BTTLab/simple_and_affordable_lps/Ultimate_LPS.pdf

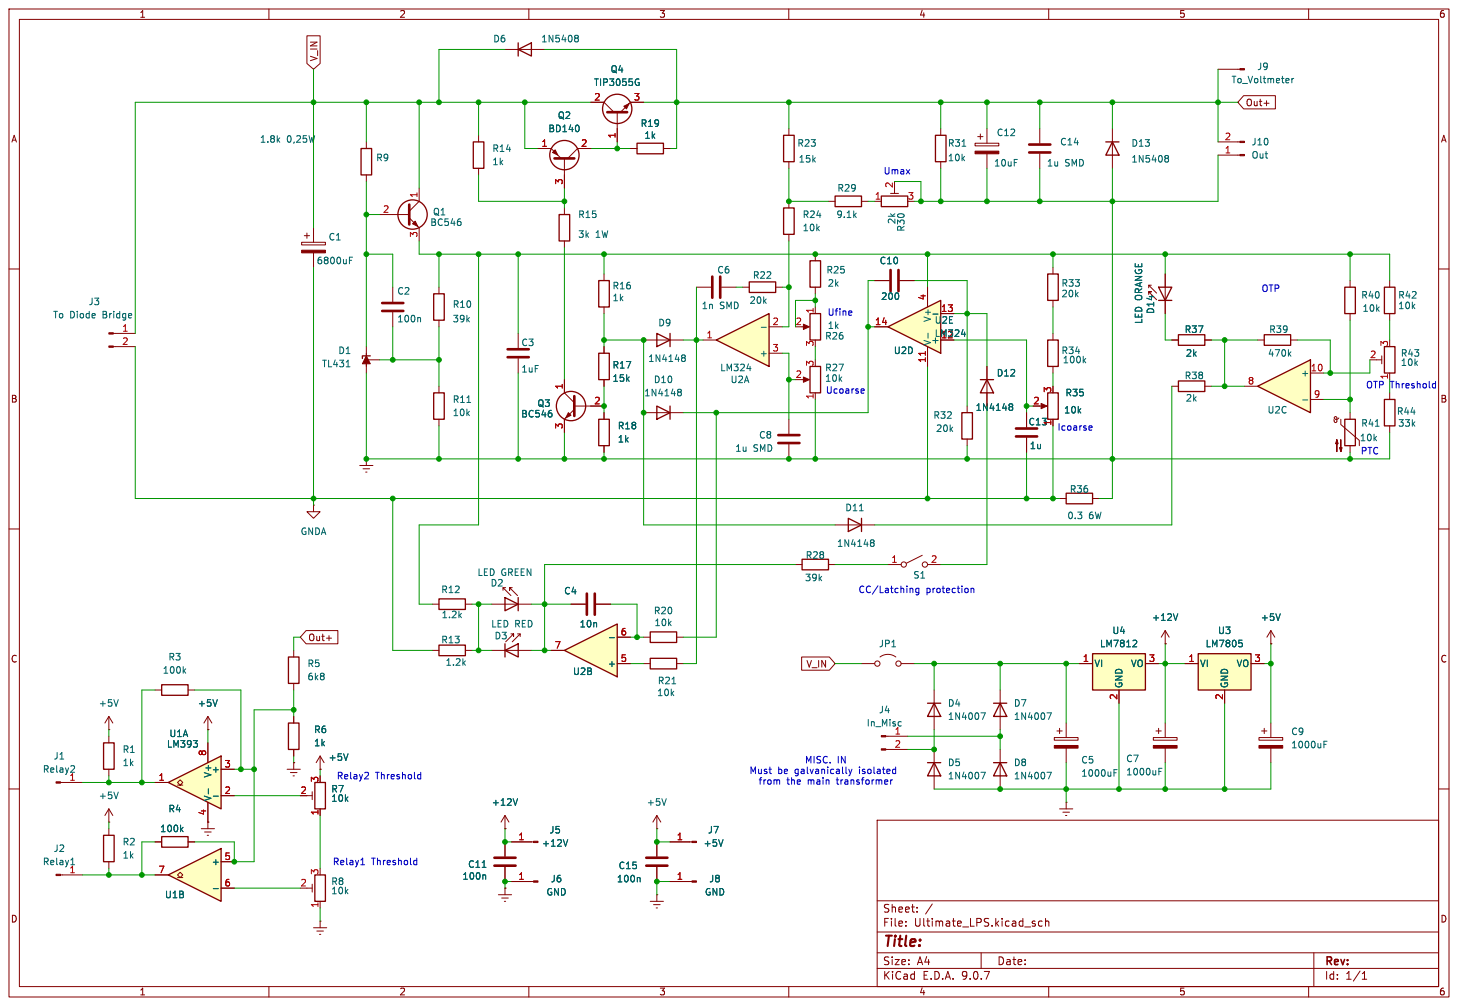
[picture p1: page 1]

Id: 1/1 Title: File: Ultimate_LPS.kicad_sch Sheet: /
