BTTLab/simple_and_affordable_lps/Ultimate_LPS/Ultimate_LPS.kicad_pcb

## KiCad design Ultimate_LPS/Ultimate_LPS.kicad_pcb (2026-10-14)

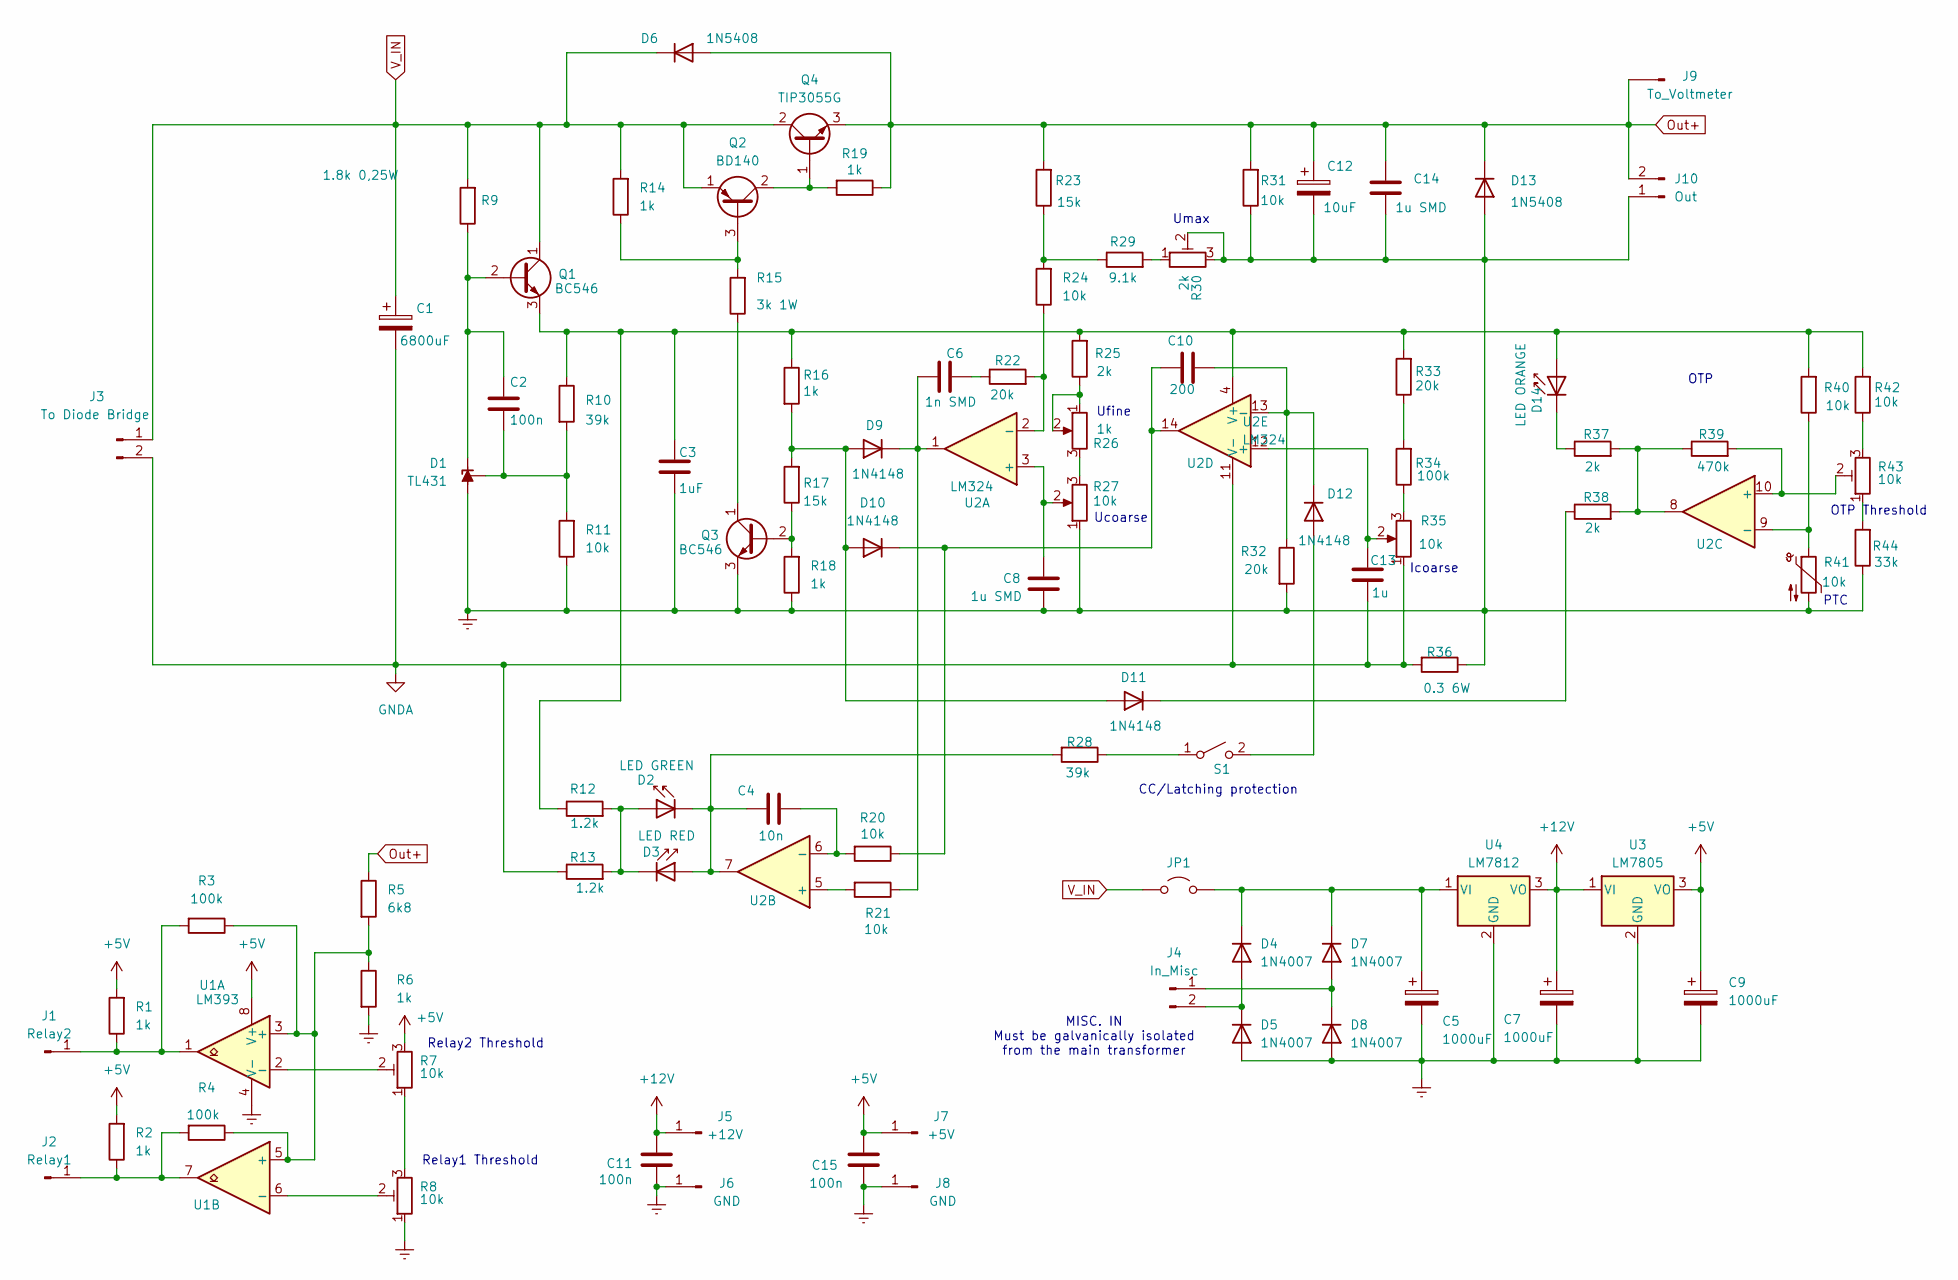
[picture p2: schematic Ultimate_LPS.kicad_sch]

Parts:
C1: 6800uF; CP_Radial_D35.0mm_P10.00mm_SnapIn
C2: 100n; C_Rect_L13.0mm_W5.0mm_P10.00mm_FKS3_FKP3_MKS4
C3: 1uF; C_1206_3216Metric_Pad1.33x1.80mm_HandSolder
C4: 10n; C_Rect_L13.0mm_W5.0mm_P10.00mm_FKS3_FKP3_MKS4
C5, C7, C9: 1000uF; CP_Radial_D10.0mm_P5.00mm
C6: 1n SMD; C_0603_1608Metric_Pad1.08x0.95mm_HandSolder
C8, C14: 1u SMD; C_1206_3216Metric_Pad1.33x1.80mm_HandSolder
C10: 200; C_Rect_L7.0mm_W2.5mm_P5.00mm
C11, C15: 100n; C_0603_1608Metric_Pad1.08x0.95mm_HandSolder
C12: 10uF; CP_Radial_D5.0mm_P2.00mm
C13: 1u; C_Rect_L13.0mm_W5.0mm_P10.00mm_FKS3_FKP3_MKS4
D1: TL431; TO-92_Inline
D2: LED GREEN; LED_D3.0mm_IRBlack
D3: LED RED; LED_D3.0mm_IRBlack
D4, D5, D7, D8: 1N4007; D_DO-41_SOD81_P10.16mm_Horizontal
D6, D13: 1N5408; D_DO-201AD_P15.24mm_Horizontal
D9, D10, D11, D12: 1N4148; D_DO-35_SOD27_P7.62mm_Horizontal
D14: LED ORANGE; LED_D3.0mm_IRBlack
J1: Relay2; Pin_D1.0mm_L10.0mm
J2: Relay1; Pin_D1.0mm_L10.0mm
J3: To Diode Bridge; SolderWire-1sqmm_1x02_P5.4mm_D1.4mm_OD2.7mm
J4: In_Misc; SolderWire-1sqmm_1x02_P5.4mm_D1.4mm_OD2.7mm
J5: +12V; Pin_D1.0mm_L10.0mm
J6, J8: GND; Pin_D1.0mm_L10.0mm
J7: +5V; Pin_D1.0mm_L10.0mm
J9: To_Voltmeter; Pin_D1.0mm_L10.0mm
J10: Out; SolderWire-1sqmm_1x02_P5.4mm_D1.4mm_OD2.7mm
JP1: Jumper; R_Axial_DIN0204_L3.6mm_D1.6mm_P2.54mm_Vertical
Q1, Q3: BC546; TO-92_Inline
Q2: BD140; TO-126-3_Vertical
Q4: TIP3055G; TO-247-3_Vertical
R1, R2, R6, R14, R16, R18: 1k; R_Axial_DIN0207_L6.3mm_D2.5mm_P15.24mm_Horizontal
R3, R4, R34: 100k; R_Axial_DIN0207_L6.3mm_D2.5mm_P15.24mm_Horizontal
R5: 6k8; R_Axial_DIN0207_L6.3mm_D2.5mm_P15.24mm_Horizontal
R7, R8, R43: 10k; Potentiometer_Bourns_3296W_Vertical
R9: 1.8k 0,25W; R_Axial_DIN0207_L6.3mm_D2.5mm_P15.24mm_Horizontal
R10, R28: 39k; R_Axial_DIN0207_L6.3mm_D2.5mm_P15.24mm_Horizontal
R11, R20, R21, R24, R31, R42: 10k; R_Axial_DIN0207_L6.3mm_D2.5mm_P15.24mm_Horizontal
R12, R13: 1.2k; R_Axial_DIN0207_L6.3mm_D2.5mm_P15.24mm_Horizontal
R15: 3k 1W; R_Axial_DIN0309_L9.0mm_D3.2mm_P15.24mm_Horizontal
R17, R23: 15k; R_Axial_DIN0207_L6.3mm_D2.5mm_P15.24mm_Horizontal
R19: 1k; R_Axial_DIN0207_L6.3mm_D2.5mm_P10.16mm_Horizontal
R22, R32, R33: 20k; R_Axial_DIN0207_L6.3mm_D2.5mm_P15.24mm_Horizontal
R25, R37, R38: 2k; R_Axial_DIN0207_L6.3mm_D2.5mm_P15.24mm_Horizontal
R26: 1k; Potentiometer_Piher_PC-16_Single_Horizontal
R27, R35: 10k; Potentiometer_Piher_PC-16_Single_Horizontal
R29: 9.1k; R_Axial_DIN0207_L6.3mm_D2.5mm_P15.24mm_Horizontal
R30: 2k; Potentiometer_Bourns_3296W_Vertical
R36: 0.3 6W; R_Axial_Power_L25.0mm_W9.0mm_P27.94mm
R39: 470k; R_Axial_DIN0207_L6.3mm_D2.5mm_P15.24mm_Horizontal
R40: 10k; R_1206_3216Metric_Pad1.30x1.75mm_HandSolder
R41: 10k; PinHeader_1x02_P2.54mm_Vertical
R44: 33k; R_Axial_DIN0207_L6.3mm_D2.5mm_P15.24mm_Horizontal
S1: PinHeader_1x02_P2.54mm_Vertical
U1: LM393; DIP-8_W7.62mm_LongPads
U2: LM324; DIP-14_W7.62mm_LongPads
U3: LM7805; TO-220-3_Vertical
U4: LM7812; TO-220-3_Vertical

Connections:
+5V: C9.1, C15.2, J7.1, R1.2, R2.2, R7.3, U1.8 (V+), U3.3 (VO)
+12V: C7.1, C11.2, J5.1, U3.1 (VI), U4.3 (VO)
Earth: C3.2, C5.2, C7.2, C8.2, C9.2, C11.1, C12.2, C14.2, C15.1, D1.2 (A), D5.2 (A), D8.2 (A), D13.2 (A), J6.1, J8.1, J10.1, Q3.3 (E), R6.2, R8.1, R11.1, R18.1, R27.1, R30.2, R30.3, R31.1, R32.2, R36.1, R41.2, R44.1, U1.4 (V-), U3.2 (GND), U4.2 (GND)
GNDA: C1.2, C13.2, J3.2, R13.1, R35.1, R36.2, U2.11 (V-)
unnamed: C6.2, R22.1
unnamed: C2.1, D1.3 (K), Q1.2 (B), R9.1
unnamed: C2.2, D1.1 (REF), R10.2, R11.2
unnamed: D2.2 (A), D3.1 (K), R12.2, R13.2
unnamed: C4.1, D2.1 (K), D3.2 (A), R28.2, U2.7
unnamed: D4.2 (A), D5.1 (K), J4.2
unnamed: C5.1, D4.1 (K), D7.1 (K), JP1.2 (B), U4.1 (VI)
unnamed: D7.2 (A), D8.1 (K), J4.1
unnamed: C6.1, D9.1 (K), R21.1, U2.1
unnamed: D9.2 (A), D10.2 (A), D11.2 (A), R16.2, R17.2
unnamed: C10.1, D10.1 (K), R20.1, U2.14
unnamed: D11.1 (K), R38.1
unnamed: D12.2 (A), S1.2 (B)
unnamed: C10.2, D12.1 (K), R32.1, U2.13 (-)
unnamed: C3.1, D14.2 (A), Q1.3 (E), R10.1, R12.1, R16.1, R25.2, R33.2, R40.2, R42.2, U2.4 (V+)
unnamed: D14.1 (K), R37.1
unnamed 20: J1.1, R1.1, R3.2, U1.1; also elsewhere on the board
unnamed 21: J2.1, R2.1, R4.2, U1.7; also elsewhere on the board
unnamed: Q2.3 (B), R14.1, R15.2
unnamed: Q2.2 (C), Q4.1 (B), R19.2
unnamed: Q3.2 (B), R17.1, R18.2
unnamed: Q3.1 (C), R15.1
unnamed: R7.1, R8.3
unnamed: R23.1, R24.2, R29.1
unnamed: R25.1, R26.1, R26.2
unnamed: R26.3, R27.3
unnamed: R29.2, R30.1
unnamed: R33.1, R34.2
unnamed: R34.1, R35.3
unnamed: R37.2, R38.2, R39.1, U2.8
unnamed: R42.1, R43.3
unnamed: R43.1, R44.2
unnamed: R28.1, S1.1 (A)
unnamed: R3.1, R4.1, R5.2, R6.1, U1.3 (+), U1.5 (+)
unnamed: R7.2, U1.2 (-)
unnamed: R8.2, U1.6 (-)
unnamed: C8.1, R27.2, U2.3 (+)
unnamed: R22.2, R24.1, U2.2 (-)
unnamed: R21.2, U2.5 (+)
unnamed: C4.2, R20.2, U2.6 (-)
unnamed: R39.2, R43.2, U2.10 (+)
unnamed: R40.1, R41.1, U2.9 (-)
unnamed: C13.1, R35.2, U2.12 (+)
Out+: C12.1, C14.1, D6.2 (A), D13.1 (K), J9.1, J10.2, Q4.3 (E), R5.1, R19.1, R23.2, R31.2
V_IN: C1.1, D6.1 (K), J3.1, JP1.1 (A), Q1.1 (C), Q2.1 (E), Q4.2 (C), R9.2, R14.2

Notes on the sheet:
MISC. IN Must be galvanically isolated from the main transformer
CC/Latching protection
Ufine
Relay1 Threshold
Icoarse
Ucoarse
OTP
Relay2 Threshold
PTC
OTP Threshold
Umax

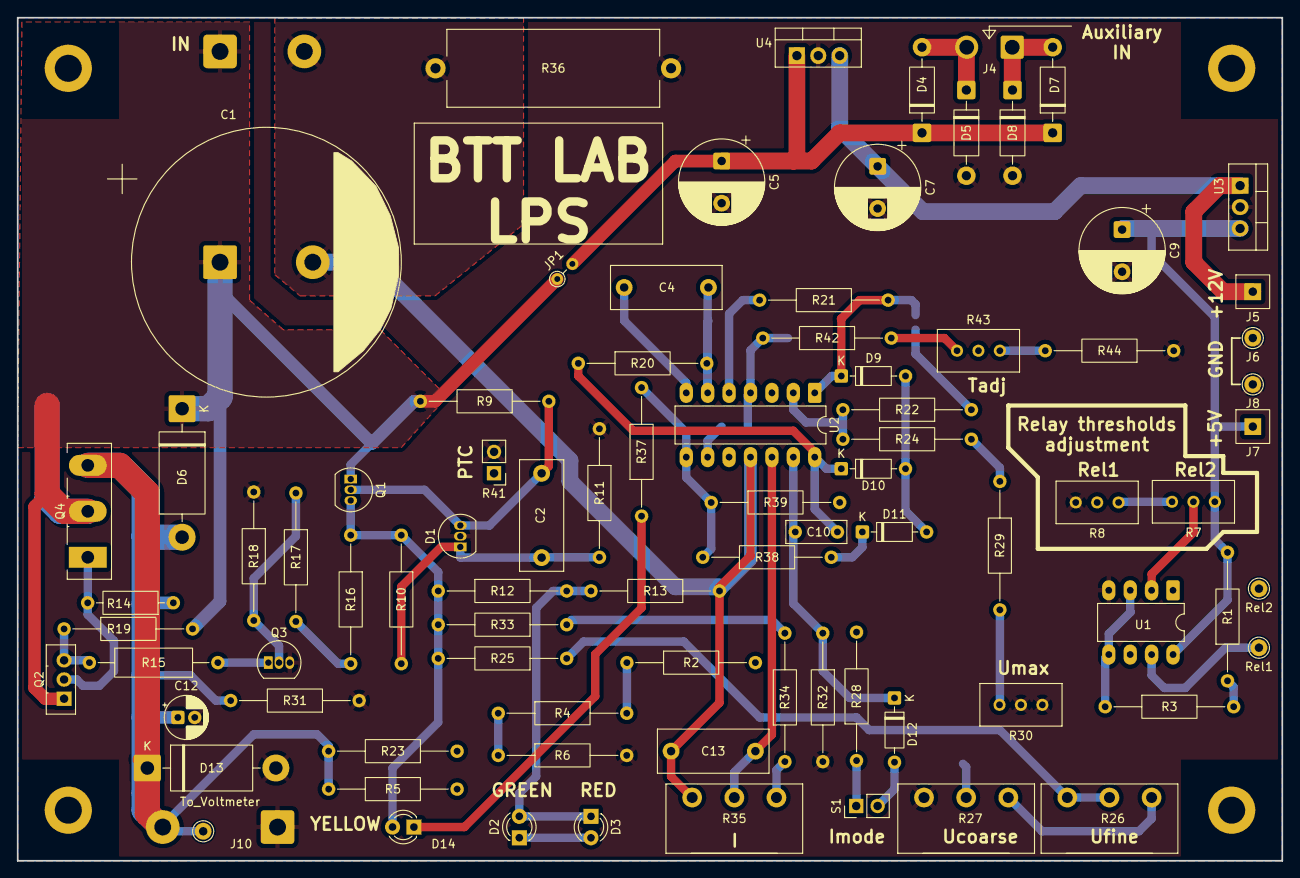
[picture p3: board Ultimate_LPS.kicad_pcb from above]

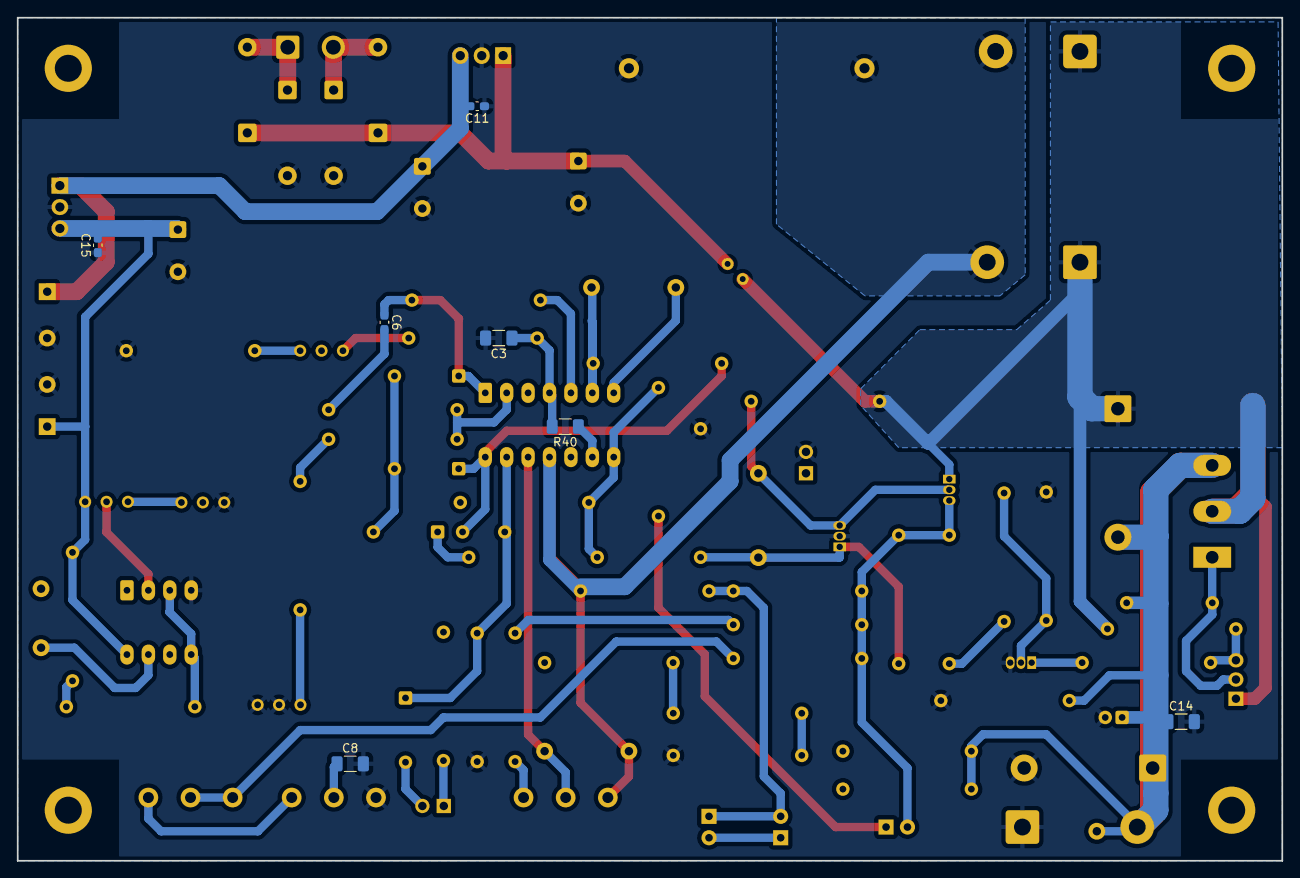
[picture p4: board Ultimate_LPS.kicad_pcb from below]

Board: 4 copper layers, 150.0 x 100.0 mm, 93 parts (7 on the bottom side), 49 nets.

Other parts of the board:
Rel1: Relay1; Pin_D1.0mm_L10.0mm
Rel2: Relay2; Pin_D1.0mm_L10.0mm

Their connections:
unnamed 20: Rel2.1; also elsewhere on the board
unnamed 21: Rel1.1; also elsewhere on the board
